arnaudcazale/nanomade_BLE_Touch_Screen_PCB/Nordic_PCB.png

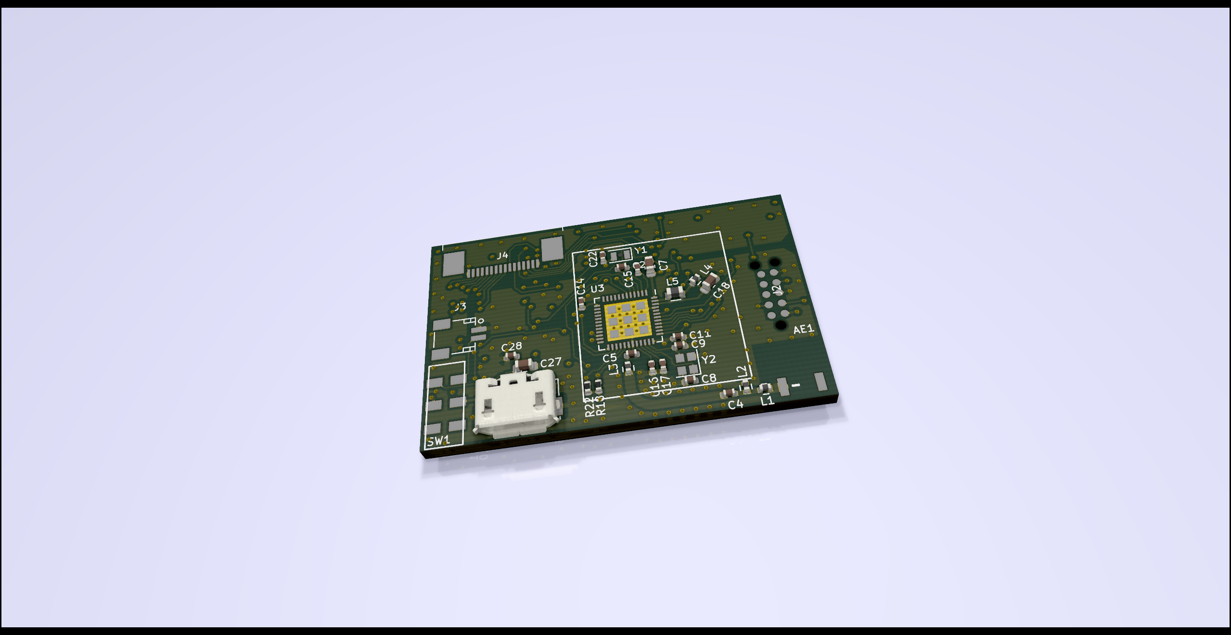
Nordic_PCB.png
