arnaudcazale/nanomade_BLE_Touch_Screen_PCB/Nordic_PCB.kicad_pcb

## KiCad design Nordic_PCB.kicad_pcb (2020-05-04)

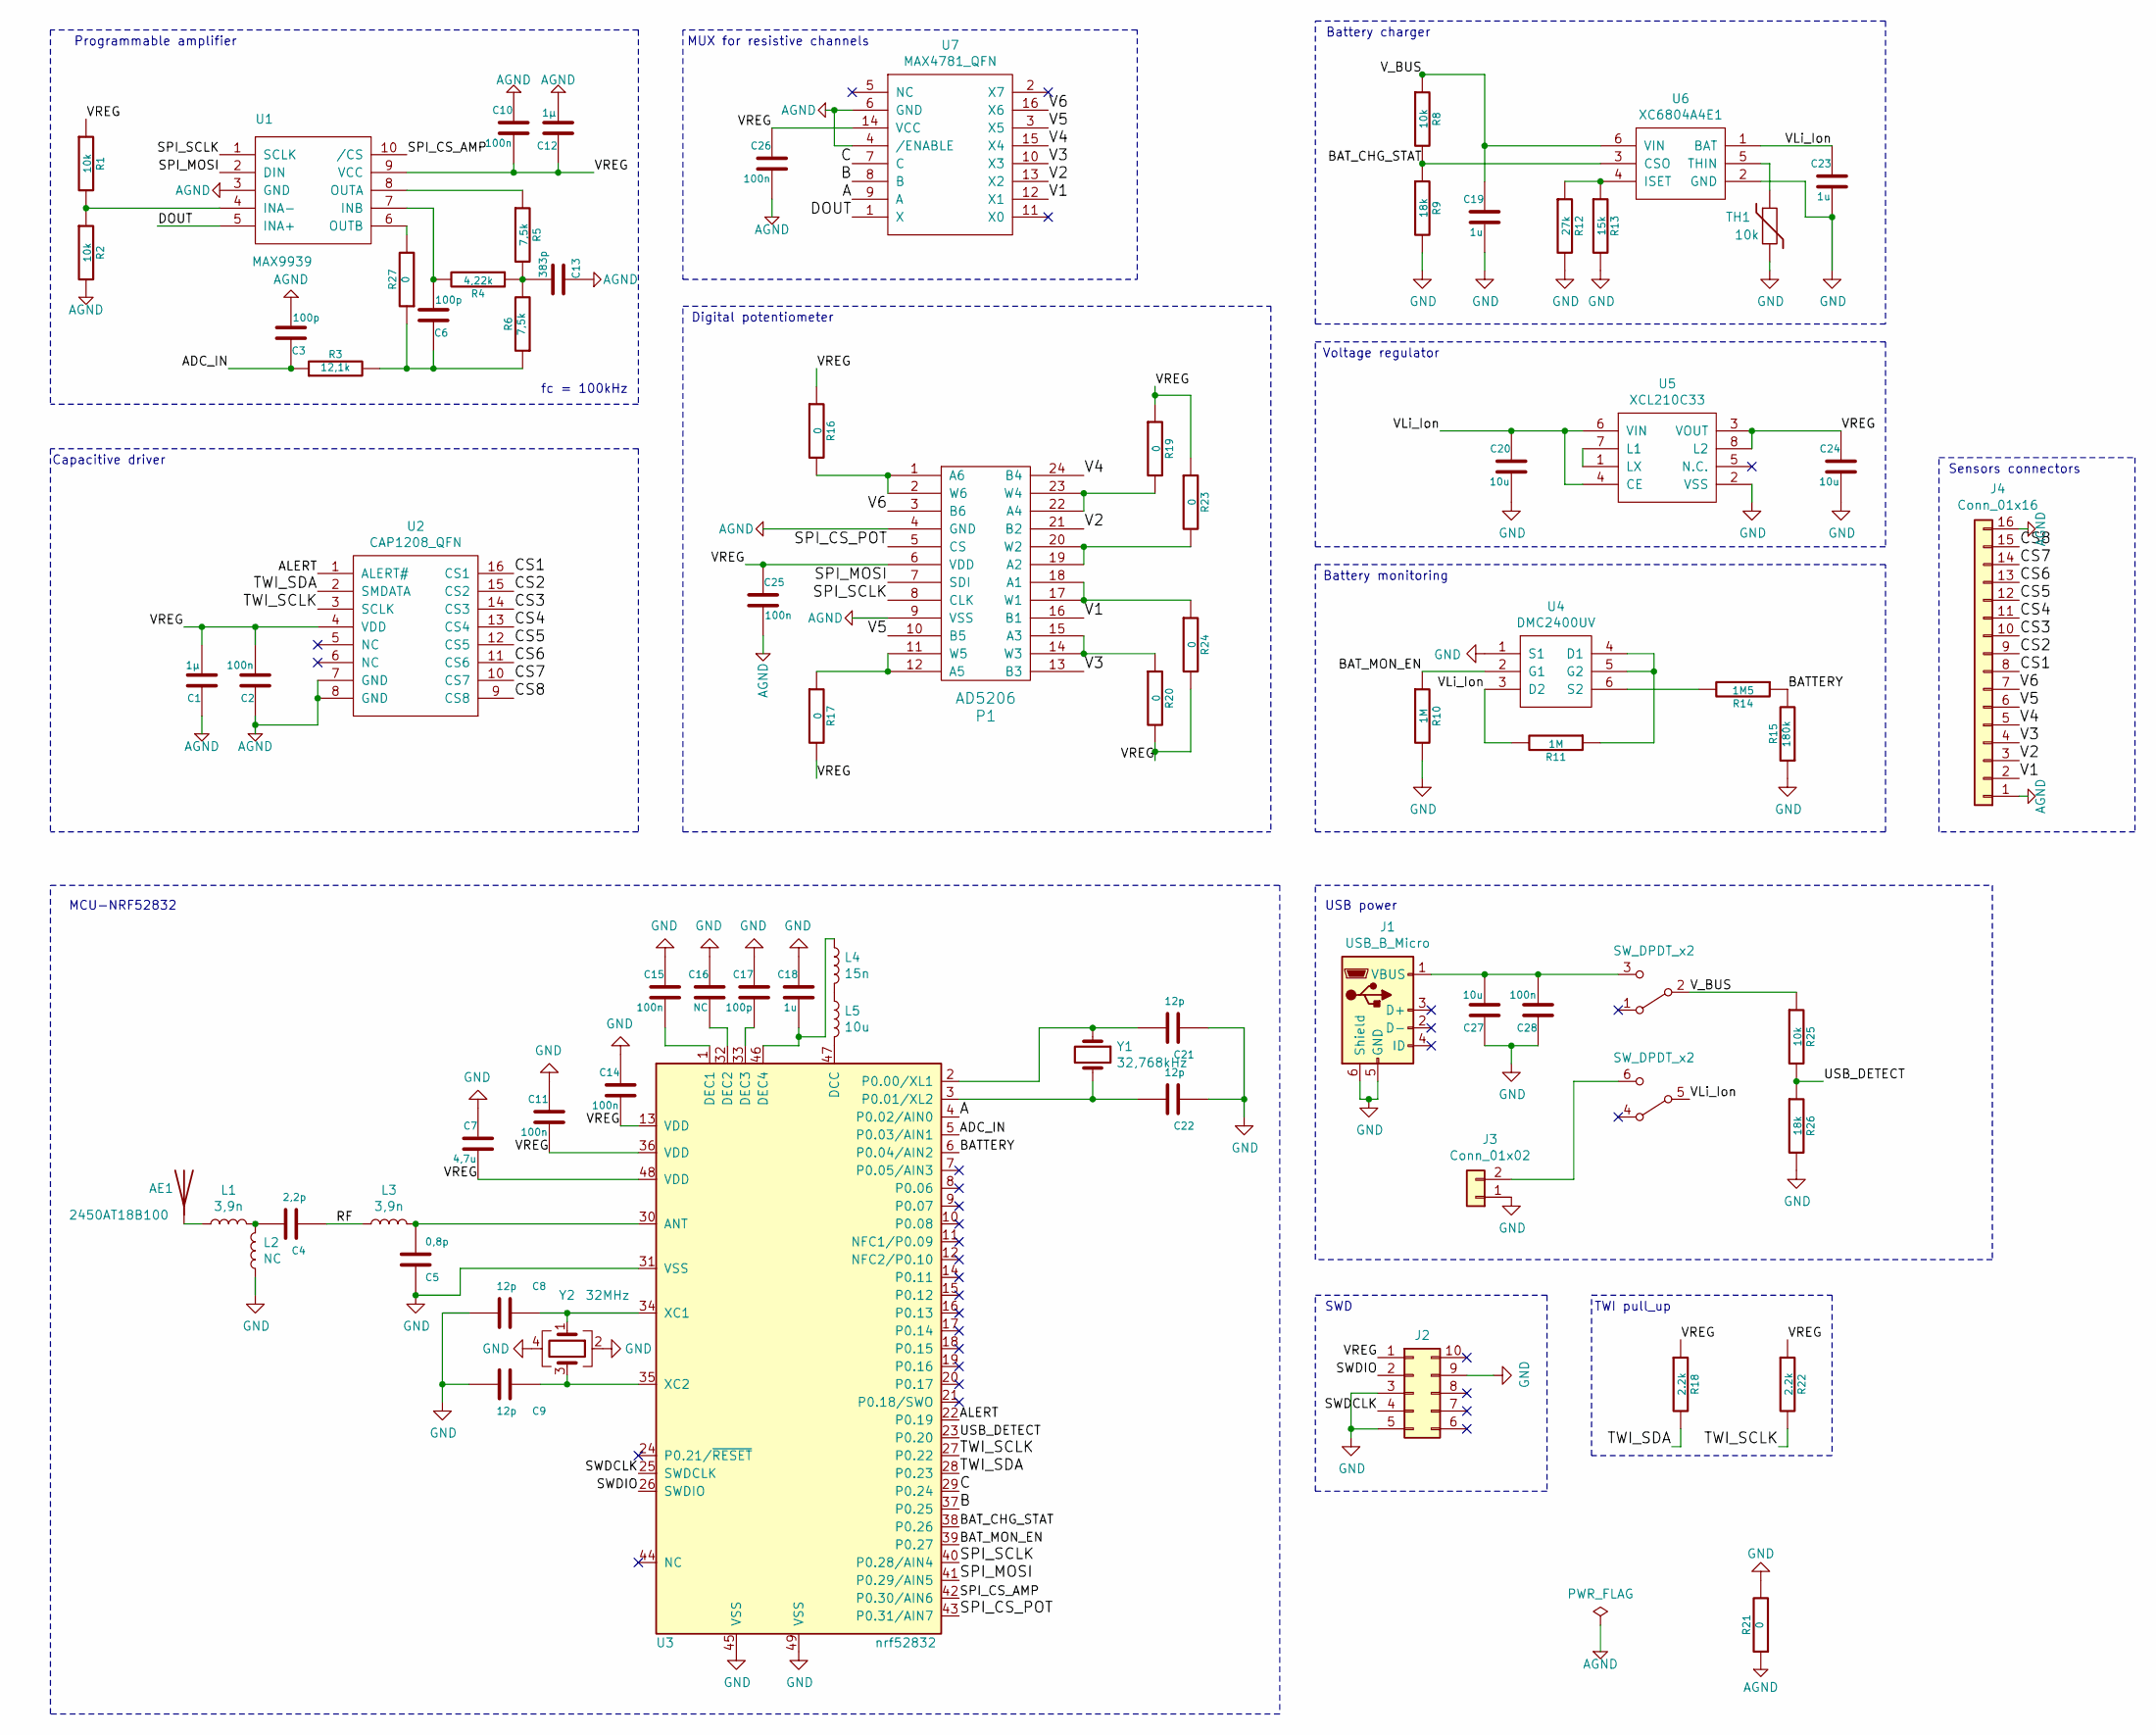
[picture p2: schematic Nordic_PCB.sch]

Parts:
AE1: 2450AT18B100
C1, C12: 1µ; C_0603_1608Metric
C2, C10, C11, C14, C15, C25, C26, C28: 100n; C_0402_1005Metric
C3, C6, C17: 100p; C_0402_1005Metric
C4: 2,2p; C_0402_1005Metric
C5: 0,8p; C_0402_1005Metric
C7: 4,7u; C_0603_1608Metric
C8, C9, C21, C22: 12p; C_0402_1005Metric
C13: 383p; C_0402_1005Metric
C16: NC; C_0402_1005Metric
C18, C19, C23: 1u; C_0603_1608Metric
C20, C24, C27: 10u; C_0603_1608Metric
J1: USB_B_Micro; USB_Micro-B_Molex_47346-0001
J2: Conn_02x05_Counter_Clockwise; Tag_Connect_10
J3: Conn_01x02; JST_SH_SM02B-SRSS-TB_02x1.00mm_Angled
J4: Conn_01x16; 117345926
L1, L3: 3,9n; L_0402
L2: NC; L_0402
L4: 15n; L_0402
L5: 10u; L_0603
P1: AD5206; TSSOP-24_4.4x7.8mm_Pitch0.65mm
R1, R2, R8, R25: 10k; R_0402_1005Metric
R3: 12,1k; R_0402_1005Metric
R4: 4,22k; R_0402_1005Metric
R5, R6: 7,5k; R_0402_1005Metric
R9, R26: 18k; R_0402_1005Metric
R10, R11: 1M; R_0402_1005Metric
R12: 27k; R_0402_1005Metric
R13: 15k; R_0402_1005Metric
R14: 1M5; R_0402_1005Metric
R15: 180k; R_0402_1005Metric
R16, R17, R19, R20, R21, R23, R24, R27: 0; R_0402_1005Metric
R18, R22: 2.2k; R_0402_1005Metric
SW1: SW_DPDT_x2; JS202011JCQN-DPDT
TH1: 10k; R_0402_1005Metric
U1: MAX9939; MSOP-10_3x3mm_Pitch0.5mm
U2: CAP1208_QFN; QFN-16-1EP_3x3mm_Pitch0.5mm_ThermalVias
U3: nrf52832; QFN-48-1EP_6x6mm_Pitch0.4mm_ThermalVias
U4: DMC2400UV; SOT-563
U5: XCL210C33; CL-2025-02
U6: XC6804A4E1; USP-6EL
U7: MAX4781_QFN; QFN-16-1EP_3x3mm_Pitch0.5mm
Y1: 32,768kHz; Crystal_SMD_2012-2pin_2.0x1.2mm
Y2: 32MHz; Crystal_SMD_2016-4pin_2.0x1.6mm

Connections:
/A: U3.4 (P0.02/AIN0), U7.9 (A)
/ADC_IN: C3.1, R3.1, U3.5 (P0.03/AIN1)
/ALERT: U2.1 (ALERT#), U3.22 (P0.19)
/B: U3.37 (P0.25), U7.8 (B)
/BATTERY: R14.1, R15.2, U3.6 (P0.04/AIN2)
/BAT_CHG_STAT: R8.2, R9.1, U3.38 (P0.26), U6.3 (CSO)
/BAT_MON_EN: R10.1, U3.39 (P0.27), U4.2 (G1)
/C: U3.29 (P0.24), U7.7 (C)
/CS1: J4.8, U2.16 (CS1)
/CS2: J4.9, U2.15 (CS2)
/CS3: J4.10, U2.14 (CS3)
/CS4: J4.11, U2.13 (CS4)
/CS5: J4.12, U2.12 (CS5)
/CS6: J4.13, U2.11 (CS6)
/CS7: J4.14, U2.10 (CS7)
/CS8: J4.15, U2.9 (CS8)
/DOUT: U1.5 (INA+), U7.1 (X)
/RF: C4.1, L3.1; also elsewhere on the board
/SPI_CS_AMP: U1.10 (/CS), U3.42 (P0.30/AIN6)
/SPI_CS_POT: P1.5 (CS), U3.43 (P0.31/AIN7)
/SPI_MOSI: P1.7 (SDI), U1.2 (DIN), U3.41 (P0.29/AIN5)
/SPI_SCLK: P1.8 (CLK), U1.1 (SCLK), U3.40 (P0.28/AIN4)
/SWDCLK: J2.4, U3.25 (SWDCLK)
/SWDIO: J2.2, U3.26 (SWDIO)
/TWI_SCLK: R22.2, U2.3 (SCLK), U3.27 (P0.22)
/TWI_SDA: R18.2, U2.2 (SMDATA), U3.28 (P0.23)
/USB_DETECT: R25.2, R26.1, U3.23 (P0.20)
/V1: J4.2, P1.16 (B1), U7.12 (X1)
/V2: J4.3, P1.21 (B2), U7.13 (X2)
/V3: J4.4, P1.13 (B3), U7.10 (X3)
/V4: J4.5, P1.24 (B4), U7.15 (X4)
/V5: J4.6, P1.10 (B5), U7.3 (X5)
/V6: J4.7, P1.3 (B6), U7.16 (X6)
/VLi_Ion: C20.1, C23.1, R11.2, SW1.5 (B), U4.3 (D2), U5.4 (CE), U5.6 (VIN), U6.1 (BAT)
/VREG: C1.2, C2.2, C7.2, C10.2, C11.2, C12.1, C14.2, C24.1, C25.1, C26.1, J2.1, P1.6 (VDD), R1.1, R16.1, R17.2, R18.1, R19.1, R20.2, R22.1, R23.1, R24.2, U1.9 (VCC), U2.4 (VDD), U3.13 (VDD), U3.36 (VDD), U3.48 (VDD), U5.3 (VOUT), U5.8 (L2), U7.14 (VCC)
/V_BUS: C19.1, R8.1, R25.1, SW1.2 (B), U6.6 (VIN)
AGND: C1.1, C2.1, C3.2, C10.1, C12.2, C13.1, C25.2, C26.2, J4.1, J4.16, P1.4 (GND), P1.9 (VSS), R2.2, R21.1, U1.3 (GND), U2.7 (GND), U2.8 (GND), U7.4 (/ENABLE), U7.6 (GND)
GND: C5.1, C7.1, C8.2, C9.2, C11.1, C14.1, C15.1, C16.1, C17.1, C18.1, C19.2, C20.2, C21.1, C22.1, C23.2, C24.2, C27.1, C28.1, J1.5 (GND), J1.6 (Shield), J2.3, J2.5, J2.9, J3.1, L2.1, R9.2, R10.2, R12.2, R13.2, R15.1, R21.2, R26.2, TH1.2, U3.31 (VSS), U3.45 (VSS), U3.49 (VSS), U4.1 (S1), U5.2 (VSS), U6.2 (GND), Y2.2, Y2.4
unnamed: AE1.1, L1.1
unnamed: C4.2, L1.2, L2.2
unnamed: C5.2, L3.2, U3.30 (ANT)
unnamed: C6.1, R3.2, R6.1, R27.1
unnamed: C6.2, R4.2, U1.7 (INB)
unnamed: C8.1, U3.34 (XC1), Y2.1
unnamed: C9.1, U3.35 (XC2), Y2.3
unnamed: C13.2, R4.1, R5.2, R6.2
unnamed: C15.2, U3.1 (DEC1)
unnamed: C16.2, U3.32 (DEC2)
unnamed: C17.2, U3.33 (DEC3)
unnamed: C18.2, L4.1, U3.46 (DEC4)
unnamed: C21.2, U3.2 (P0.00/XL1), Y1.1
unnamed: C22.2, U3.3 (P0.01/XL2), Y1.2
unnamed: C27.2, C28.2, J1.1 (VBUS), SW1.3 (C)
unnamed: J3.2, SW1.6 (C)
unnamed: L4.2, L5.1
unnamed: L5.2, U3.47 (DCC)
unnamed: P1.1 (A6), P1.2 (W6), R16.2
unnamed: P1.11 (W5), P1.12 (A5), R17.1
unnamed: P1.14 (W3), P1.15 (A3), R20.1
unnamed: P1.17 (W1), P1.18 (A1), R24.1
unnamed: P1.19 (A2), P1.20 (W2), R23.2
unnamed: P1.22 (A4), P1.23 (W4), R19.2
unnamed: R1.2, R2.1, U1.4 (INA-)
unnamed: R5.1, U1.8 (OUTA)
unnamed: R11.1, U4.4 (D1), U4.5 (G2)
unnamed: R12.1, R13.1, U6.4 (ISET)
unnamed: R14.2, U4.6 (S2)
unnamed: R27.2, U1.6 (OUTB)
unnamed: TH1.1, U6.5 (THIN)
unnamed: U5.1 (LX), U5.7 (L1)

Notes on the sheet:
Capacitive driver
Digital potentiometer
MUX for resistive channels
Programmable amplifier
Battery charger
Voltage regulator
Battery monitoring
TWI pull_up
MCU-NRF52832
USB power
SWD
Sensors connectors
fc = 100kHz

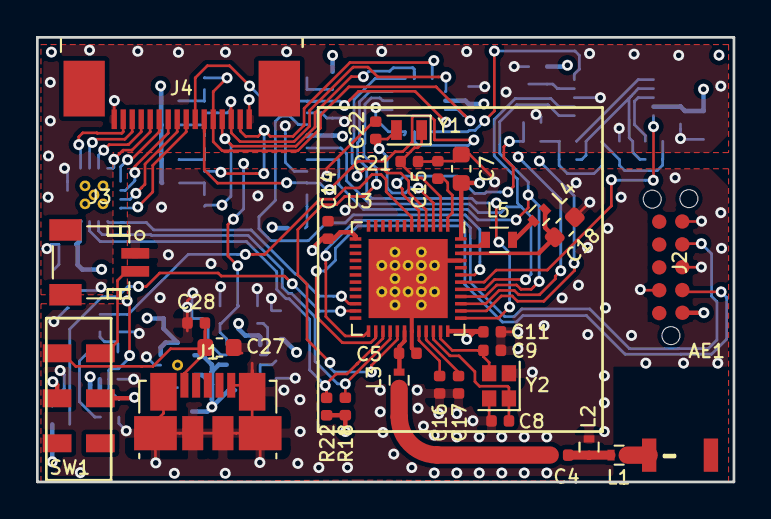
[picture p3: board Nordic_PCB.kicad_pcb from above]

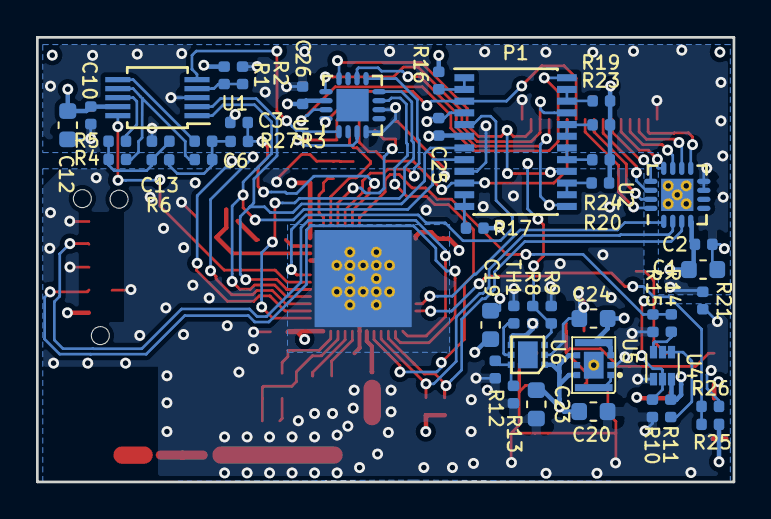
[picture p4: board Nordic_PCB.kicad_pcb from below]

Board: 4 copper layers, 38.7 x 24.7 mm, 77 parts (45 on the bottom side), 70 nets.

Other parts of the board:
uwA*****: uwArc0.96_2.12_90

Their connections:
/RF: uwA*****.1; also elsewhere on the board
