arnaudcazale/nanomade_BLE_Touch_Screen_PCB/(commit log)

2020-05-04 Design checker OK
    [Nordic_PCB.kicad_pcb]
2020-05-07 BOM added
    [BOM.csv]
